Distaff/RPi_CM_Drone_Board/CM5IO_BOM.xlsx

Sheet: Bottom
Qty/ board | Ref | Value | Footprint | Desc | Part No. | MOUSER |  | Farnell |  | TME
 |  |  |  |  |  | Unit Price | Code | Unit Price | Code | Unit Price | Code | min. Il. na 10 płytek
4 | C9,C12,C13,C18 | 100n | Capacitor_SMD:C_0402_1005Metric | 0.1uF 10% 16V Ceramic Capacitor X7R 0402 (1005 Metric) | - |  |  |  |  | 0.04 zł | 04025C104KAT2A (https://www.tme.eu/pl/details/04025c104kat2a/kondensatory-mlcc-smd/kyocera-avx/) | 12 | 0.47 zł
1 | CP6 | 33pF | Capacitor_SMD:C_0805_2012Metric_Pad1.18x1.45mm_HandSolder | - | - |  |  |  |  | 0.20 zł | 08055A330KAT2A (https://www.tme.eu/pl/details/08055a330kat2a/kondensatory-mlcc-smd/kyocera-avx/) | 12 | 2.46 zł
1 | CP5 | 2.7nF | Capacitor_SMD:C_0805_2012Metric_Pad1.18x1.45mm_HandSolder | - | - |  |  |  |  | 0.18 zł | 08055C272KAT2A (https://www.tme.eu/pl/details/08055c272kat2a/kondensatory-mlcc-smd/kyocera-avx/) | 12 | 2.19 zł
1 | CP7 | 10nF | Capacitor_SMD:C_0805_2012Metric_Pad1.18x1.45mm_HandSolder | - | - |  |  |  |  | 0.14 zł | 08055C103KAT2A (https://www.tme.eu/pl/details/08055c103kat2a/kondensatory-mlcc-smd/kyocera-avx/) | 12 | 1.71 zł
1 | CP4 | 100nF | Capacitor_SMD:C_0805_2012Metric_Pad1.18x1.45mm_HandSolder | - | - |  |  |  |  | 0.04 zł | 08055C104KAT2A (https://www.tme.eu/pl/details/08055c104kat2a/kondensatory-mlcc-smd/kyocera-avx/) | 12 | 0.50 zł
4 | C2,C5,C7,C8 | 10u | Capacitor_SMD:C_0805_2012Metric | 10uF 10% 10V Ceramic Capacitor X7R 0805 (2012 Metric) | - |  |  |  |  | 0.28 zł | 08055C105KAT2A (https://www.tme.eu/pl/details/08055c105kat2a/kondensatory-mlcc-smd/kyocera-avx/) | 42 | 11.85 zł
3 | R1,R2,R10 | 1k | Resistor_SMD:R_0402_1005Metric | Resistor 1K M1005 1% 63mW | - |  |  |  |  | 0.03 zł | SMD0402-1K-1% (https://www.tme.eu/pl/details/smd0402-1k-1%25/rezystory-smd/royalohm-royal-electronic-fty-co/0402wgf1001tce/) | 100 | 3.31 zł
4 | R6,R7,R8,R9 | 2.2K 1% | Resistor_SMD:R_0402_1005Metric | Resistor 2.2K M1005 1% 63mW | - |  |  |  |  | 0.04 zł | SMD0402-2K2-1% (https://www.tme.eu/pl/details/smd0402-2k2-1%25/rezystory-smd/royalohm-royal-electronic-fty-co/0402wgf2201tce/) | 100 | 3.91 zł
2 | R11,R13 | 10K 1% | Resistor_SMD:R_0402_1005Metric | Resistor 10K M1005 1% 63mW | - |  |  |  |  | 0.02 zł | SMD0402-10K-1% (https://www.tme.eu/pl/details/smd0402-10k-1%25/rezystory-smd/royalohm-royal-electronic-fty-co/0402wgf1002tce/) | 100 | 1.76 zł
1 | R12 | 15K 1% | Resistor_SMD:R_0402_1005Metric | Resistor 15K M1005 1% 63mW | - |  |  |  |  | 0.04 zł | SMD0402-15K-1% (https://www.tme.eu/pl/details/smd0402-15k-1%25/rezystory-smd/royalohm-royal-electronic-fty-co/0402wgf1502tce/) | 100 | 3.66 zł
1 | RP1 | 115K | Resistor_SMD:R_0805_2012Metric_Pad1.20x1.40mm_HandSolder | - | - |  |  |  |  | 0.22 zł | ERA6AEB1153V (https://www.tme.eu/pl/details/era6aeb1153v/rezystory-smd/panasonic-industry-europe-gmbh/) | 12 | 2.59 zł
1 | RP2 | 22.1K | Resistor_SMD:R_0805_2012Metric_Pad1.20x1.40mm_HandSolder | - | - |  |  |  |  | 0.06 zł | SMD0805-22K1-1% (https://www.tme.eu/pl/details/smd0805-22k1-1%25/rezystory-smd/royalohm-royal-electronic-fty-co/0805s8f2212t5e/) | 100 | 5.94 zł
1 | RP3 | 15.8K | Resistor_SMD:R_0805_2012Metric_Pad1.20x1.40mm_HandSolder | - | - |  |  |  |  | 0.07 zł | SMD0805-15.8K-1% (https://www.tme.eu/pl/details/smd0805-15.8k-1%25/rezystory-smd/royalohm-royal-electronic-fty-co/0805s8f1582t5e/) | 100 | 6.71 zł
1 | J1 | POWER TERMINAL | TerminalBlock:TerminalBlock_bornier-2_P5.08mm | - | - |  |  |  |  |  | Will be unused |  | 0.00 zł
1 | J2 | Conn_02x06_Odd_Even | Connector_PinHeader_2.00mm:PinHeader_2x06_P2.00mm_Vertical | PinHeader_2x06_P2.54mm_Vertical | - |  |  |  |  | 1.09 zł | ZL303-2X40P (https://www.tme.eu/pl/details/zl303-2x40p/listwy-i-gniazda-kolkowe/connfly/ds1025-05-2x40p8bv1-b/) | 10 | 10.93 zł
2 | J2 |  |  | Zwory do J2 |  |  |  |  |  | 0.29 zł | JUMPER-2.0/B (https://www.tme.eu/pl/details/jumper-2.0_b/listwy-i-gniazda-kolkowe/ninigi/) | 12 | 3.53 zł
1 | J4 | J_PSU_EN | Connector_PinHeader_2.54mm:PinHeader_1x02_P2.54mm_Vertical | - | - |  |  |  |  |  |  |  | 0.00 zł
1 | J8 | THD-20-R | Connector_PinHeader_2.54mm:PinHeader_2x20_P2.54mm_Vertical | PinHeader_2x20_P2.54mm_Vertical | THD-20-R
 |  |  |  |  |  |  |  |  |  |  |  | SUMA | 61.50 zł
1 | CP1 | 10uF | Capacitor_Tantalum_SMD:CP_EIA-3528-21_Kemet-C_HandSolder | Tantalum, Kemet-C, 10uF@35V min. | - |  |  |  |  | 3.74 zł | TAJC106K035R (https://www.tme.eu/pl/details/tajc106k035r/kondensatory-tantalowe-smd/kyocera-avx/tajc106k035rnj/)
2 | CP2,CP3 | 22uF | Capacitor_Tantalum_SMD:CP_EIA-3528-21_Kemet-B_HandSolder | Tantalum, Kemet-B, 22uF@10V min. | - |  |  |  |  | 1.64 zł | TAJB226K016R (https://www.tme.eu/pl/details/tajb226k016r/kondensatory-tantalowe-smd/kyocera-avx/tajb226k016rnj/)
1 | C3 | 100uF | Capacitor_Tantalum_SMD:CP_EIA-7343-31_Kemet-D | Kemet-D, 10V | - |  |  |  |  | 2.28 zł | TAJD106K035R (https://www.tme.eu/pl/details/tajd106k035r/kondensatory-tantalowe-smd/kyocera-avx/tajd106k035rnj/)
2 | D1,D3 | LED Red | LED_SMD:LED_0603_1608Metric | Red 620nm LED Indication - Discrete 2.2V 2-SMD, No Lead | SML-A12U8TT86Q | 0.38 zł | 859-LTST-S270KRKT (https://www.mouser.pl/ProductDetail/LITEON/LTST-S270KRKT?qs=NUb82WqeCyrkrhATBGeB1A%3D%3D) | 1.65 zł | 3434715 (https://pl.farnell.com/rohm/sml-a12u8tt86/led-red-63mcd-620nm/dp/3434715) | 0.00 zł | -
1 | D2 | LED Green | LED_SMD:LED_0603_1608Metric | Green 572nm LED Indication - Discrete 2.2V 2-SMD, No Lead | SML-A12M8TT86N | 0.30 zł | 859-LTST-S270KGKT (https://www.mouser.pl/ProductDetail/LITEON/LTST-S270KGKT?qs=oL5uk4n%2FG821%2FMiCU6RADg%3D%3D) | 1.64 zł | 3434712 (https://pl.farnell.com/rohm/sml-a12m8tt86/led-yellow-green-25mcd-572nm/dp/3434712) | 0.00 zł | -
2 | J5,J16 | Conn_01x22_Female | CM5IO:Hirose_FH12-22S-0.5SH_1x22-1MP_P0.50mm_Horizontal | 22 Position FFC, FPC Connector Contacts, Bottom 0.020" (0.50mm) Surface Mount, Right Angle | FH12-22S-0.5SH55 | 5.68 zł | 798-FH12-22S-0.5SH55 (https://www.mouser.pl/ProductDetail/Hirose-Connector/FH12-22S-0.5SH55?qs=Ux3WWAnHpjDjN9JNAugKTA%3D%3D) | 7.17 zł | 2300373 (https://pl.farnell.com/hirose-hrs/fh12-22s-1sh-55/connector-fpc-ffc-smt-1mm-22way/dp/2300373) | 0.00 zł | -
1 | J7 | Micro_SD_Card_Det | CM5IO:SDCARD_MOLEX_503398-1892 | 9 (8 + 1) Position Card Connector microSDâ„¢ Surface Mount, Right Angle Gold | 503398-1892 |  |  |  |  | 8.41 zł | MX-503398-1892 (https://www.tme.eu/pl/details/mx-503398-1892/zlacza-do-kart/molex-interconnect-gmbh/503398-1892/) | Not necessary, if no SD card is used
1 | J11 | USB_C_Receptacle_USB2.0 | Connector_USB:USB_C_Receptacle_GCT_USB4105-xx-A_16P_TopMnt_Horizontal | USBC USB2 data and power connector | USBF31-0171 |  |  |  |  | 2.51 zł | USB4105-GF-A-060 (substitute) (https://www.tme.eu/pl/details/usb4105-gf-a-060/zlacza-usb-i-ieee1394/gct/)
1 | J12 | USB3_A | Connector_USB:USB3_A_Molex_48393-001 | USB 3.0 A connector | 48393-0003 |  |  |  |  | 9.67 zł | MX-48393-0003 (https://www.tme.eu/pl/details/mx-48393-0003/zlacza-usb-i-ieee1394/molex-interconnect-gmbh/48393-0003/)
1 | J14 | JST_SHBM04B-SRSS-TB | Connector_JST:JST_SH_BM04B-SRSS-TB_1x04-1MP_P1.00mm_Vertical | 4 pin vertical 1mm pitch connector | SHBM04B-SRSS-TB |  |  |  |  | 1.44 zł | SM04B-SRSS-TB (https://www.tme.eu/pl/details/sm04b-srss-tb/zlacza-sygnalowe-raster-1-00mm/jst-j-s-t-deutschland-gmbh/sm04b-srss-tb-lf-sn/)
1 | J22 | 46765-1301 | CM5IO:CONN_467651301_MOL | 0.40mm Pitch Micro HDMI Connector, Right-Angle Receptacle, Surface Mount, with Through Hole Shell Tabs and Pick-and-Place Polyimide Tape, 19 Circuits, Lead-Free | 46765-1301 | 7.70 zł | 538-46765-1301 (https://www.mouser.pl/ProductDetail/Molex/46765-1301?qs=73RpG39PUGhn7Y4KPCbKEQ%3D%3D) | 8.82 zł | 2614867 (https://pl.farnell.com/molex/46765-1301/hdmi-connector-rcpt-19pos-smt/dp/2614867) | 0.00 zł | -
1 | LP1 | 3.6uH | Inductor_SMD:L_Bourns-SRN8040_8x8.15mm | - | SRN8040HA-3R6M | 1.70 zł | 652-SRN8040HA-3R6M (https://www.mouser.pl/ProductDetail/Bourns/SRN8040HA-3R6M?qs=2SLPxufLcgCU8ox1jv6zYw%3D%3D) | 2.52 zł | 4216300 (https://pl.farnell.com/bourns/srn8040ha-3r6m/power-inductor-3-6uh-semishielded/dp/4216300) | 0.00 zł | -
2 | Module1 | ComputeModule5-CM5 | CM5IO:Raspberry-Pi-5-Compute-Module | 100 Position Connector Receptacle, Center Strip Contacts Surface Mount Gold | 10164227-1001A1RLF | 5.55 zł | DF40C-100DS-0.4V(51) (substitute) (https://www.mouser.pl/ProductDetail/Hirose-Connector/DF40C-100DS-0.4V51?qs=eDUdFcBPps2MEwbnuPvZzQ%3D%3D) | 7.43 zł | 4137104 (https://pl.farnell.com/amphenol-communications-solutions/10164227-1001a1rlf/mezzanine-conn-rcpt-100pos-2row/dp/4137104) | 0.00 zł | -
1 | SW1 | Right angle Tact button | Button_Switch_SMD:SW_Push_1P1T_NO_CK_KMR2 | - | KMR221G LFS |  |  |  |  | 1.05 zł | KMR221GLFS (https://www.tme.eu/pl/details/kmr221glfs/mikroprzelaczniki-tact/c-k-components-sas/kmr221g-lfs/)
1 | U6 | AP22653W6 | Package_TO_SOT_SMD:SOT-23-6 | Power Switch/Driver 1:1 P-Channel 2.1A SOT-23-6 | AP22653W6 |  |  |  |  | 1.45 zł | AP22653W6-7 (https://www.tme.eu/pl/details/ap22653w6-7/power-switches-uklady-scalone/diodes-incorporated/)
1 | U12 | RT9742SNGV | Package_TO_SOT_SMD:TSOT-23_HandSoldering | Power Switch/Driver 1:1 N-Channel 500mA SOT-23-3 | RT9742SNGV | 1.04 zł | 835-RT9742SNGV (https://www.mouser.pl/ProductDetail/Richtek/RT9742SNGV?qs=amGC7iS6iy9IuhGfX55LJA%3D%3D) | 1.50 zł | 2575555 (https://pl.farnell.com/richtek/rt9742sngv/uswi00154-rt9742sngv/dp/2575555) | 0.00 zł | -
1 | U18 | RT9742GGJ5 | Package_TO_SOT_SMD:SOT-23-5 | Power Switch/Driver 1:1 N-Channel 1A TSOT-23-5 | RT9742GGJ5 | 1.19 zł | 835-RT9742GGJ5 (https://www.mouser.pl/ProductDetail/Richtek/RT9742GGJ5?qs=amGC7iS6iy%2FZU2tAnLZxIA%3D%3D) | 0.00 zł | - | 0.00 zł | - | Not necessary, if no SD card is used
1 | UP1 | AP64501SP-13 | CM5IO:SOP_AP64501SP-13_DIO | - | AP64501SP-13 |  |  |  |  | 7.11 zł | AP64501SP-13 (https://www.tme.eu/pl/details/ap64501sp-13/regulatory-napiecia-uklady-dc-dc/diodes-incorporated/)
 |  |  |  |  |  | 35.17 zł | SUMA / płytka | 46.98 zł | SUMA / płytka | 40.94 zł | SUMA / płytka

Sheet: Top
Qty/ board | Ref | Value | Footprint | Desc | Part No. | MOUSER |  | Farnell |  | TME
 |  |  |  |  |  | Unit Price | Code | Unit Price | Code | Unit Price | Code | min. Il. na 10 płytek
1 | J8 | THD-20-R | Connector_PinHeader_2.54mm:PinHeader_2x20_P2.54mm_Vertical | TODO: to ma być gniazdo | - |  |  |  |  |  |  |  | 0.00 zł
1 | J3 | J_PSU_EN | Connector_PinHeader_2.54mm:PinHeader_1x02_P2.54mm_Vertical_SMD_Pin1Left | - | - |  |  |  |  |  |  |  | 0.00 zł
4 | C1,C2,C7,C8 | 470nF | Capacitor_SMD:C_0805_2012Metric_Pad1.18x1.45mm_HandSolder | - | - |  |  |  |  | 0.25 zł | 08055C474K4T2A (https://www.tme.eu/pl/details/08055c474k4t2a/kondensatory-mlcc-smd/kyocera-avx/) | 50 | 12.36 zł
10 | R1,R3,R4,R5,R6,R9,R10,R12,R13,R15 | 1K | Resistor_SMD:R_0805_2012Metric_Pad1.20x1.40mm_HandSolder | - | - |  |  |  |  | 0.05 zł | SMD0805-1K-1% (https://www.tme.eu/pl/details/smd0805-1k-1%25/rezystory-smd/royalohm-royal-electronic-fty-co/0805s8f1001t5e/) | 100 | 4.97 zł
1 | R2 | 2.2K 1% | Resistor_SMD:R_0805_2012Metric_Pad1.20x1.40mm_HandSolder | - | - |  |  |  |  | 0.06 zł | SMD0805-2K2-1% (https://www.tme.eu/pl/details/smd0805-2k2-1%25/rezystory-smd/royalohm-royal-electronic-fty-co/0805s8f2201t5e/) | 100 | 5.62 zł
2 | R7,R8 | 5.1K 1% | Resistor_SMD:R_0805_2012Metric_Pad1.20x1.40mm_HandSolder | - | - |  |  |  |  | 0.06 zł | SMD0805-5K1-1% (https://www.tme.eu/pl/details/smd0805-5k1-1%25/rezystory-smd/royalohm-royal-electronic-fty-co/0805s8f5101t5e/) | 100 | 5.94 zł
3 | R11,R14,R16 | 10K | Resistor_SMD:R_0805_2012Metric_Pad1.20x1.40mm_HandSolder | - | - |  |  |  |  | 0.05 zł | SMD0805-10K-1% (https://www.tme.eu/pl/details/smd0805-10k-1%25/rezystory-smd/royalohm-royal-electronic-fty-co/0805s8f1002t5e/) | 100 | 4.97 zł
 |  |  |  |  |  |  |  |  |  |  |  | SUMA/całość | 33.85 zł
2 | C3,C4 | 4.7uF 35v | Capacitor_Tantalum_SMD:CP_EIA-3528-21_Kemet-B_HandSolder | - | - |  |  |  |  | 1.68 zł | TAJB475K035R (https://www.tme.eu/pl/details/tajb475k035r/kondensatory-tantalowe-smd/kyocera-avx/tajb475k035rnj/)
2 | C5,C6 | 4.7uF 10v | Capacitor_Tantalum_SMD:CP_EIA-3216-18_Kemet-A_HandSolder | - | - |  |  |  |  | 1.48 zł | TAJA475K010R (https://www.tme.eu/pl/details/taja475k010r/kondensatory-tantalowe-smd/kyocera-avx/taja475k010rnj/)
2 | D1,D2 | MBR1020VL | Diode_SMD:D_SOD-123F | - | MBR1020VL |  |  |  |  | 0.98 zł | MBR1020VL-AU-R1 (https://www.tme.eu/pl/details/mbr1020vl-au-r1/diody-schottky-smd/panjit-semiconductor-panjit-international-inc/mbr1020vl-au-r1-000a1/)
2 | D3,D5 | LED Red | LED_SMD:LED_0603_1608Metric | Red 620nm LED Indication - Discrete 2.2V 2-SMD, No Lead | SML-A12U8TT86Q |  |  |  |  | 0.15 zł | LTST-C190KRKT (substitute) (https://www.tme.eu/pl/details/ltst-c190krkt/diody-led-smd-kolorowe/lite-on-technology/) | * - equivalent
1 | D4 | LED Green | LED_SMD:LED_0603_1608Metric | Green 572nm LED Indication - Discrete 2.2V 2-SMD, No Lead | SML-A12M8TT86N |  |  |  |  | 0.12 zł | LTST-C190KGKT (substitute) (https://www.tme.eu/pl/details/ltst-c190kgkt/diody-led-smd-kolorowe/lite-on-technology/)
1 | J1 | USB_C_Receptacle_USB2.0 | Connector_USB:USB_C_Receptacle_GCT_USB4105-xx-A_16P_TopMnt_Horizontal | - |  |  |  |  |  | 2.51 zł | USB4105-GF-A-060 (substitute) (https://www.tme.eu/pl/details/usb4105-gf-a-060/zlacza-usb-i-ieee1394/gct/)
1 | J4 | J_ESP_DBG_UART | Connector_Molex:Molex_PicoBlade_53047-0310_1x03_P1.25mm_Vertical | - | 53047-0310 |  |  |  |  | 1.05 zł | MX-53047-0310 (https://www.tme.eu/pl/details/mx-53047-0310/zlacza-sygnalowe-raster-1-25mm/molex/53047-0310/)
1 | J7 | J_FC_UART | Connector_Molex:Molex_PicoBlade_53048-0210_1x02_P1.25mm_Horizontal | - | 53048-0210 |  |  |  |  | 0.93 zł | MX-53048-0210 (https://www.tme.eu/pl/details/mx-53048-0210/zlacza-sygnalowe-raster-1-25mm/molex-interconnect-gmbh/53048-0210/)
2 | J9,J10 |  | Connector_Molex:Molex_PicoBlade_53048-0810_1x08_P1.25mm_Horizontal | - | 53048-0810 |  |  |  |  | 2.25 zł | MX-53048-0810 (https://www.tme.eu/pl/details/mx-53048-0810/zlacza-sygnalowe-raster-1-25mm/molex-interconnect-gmbh/53048-0810/)
2 | Q1,Q4 | AO3401A | Package_TO_SOT_SMD:SOT-23 | - | AO3401A |  |  |  |  | 1.24 zł | AO3401A (https://www.tme.eu/pl/details/ao3401a/tranzystory-z-kanalem-p-smd/alpha-omega-semiconductor-inc/)
2 | Q2,Q3 | Q_NPN_BEC | Package_TO_SOT_SMD:SOT-23 | -
3 | SW1,SW2,SW3 |  | Button_Switch_SMD:SW_Push_1P1T_NO_CK_KMR2 | - | KMR221G LFS |  |  |  |  | 1.05 zł | KMR221GLFS (https://www.tme.eu/pl/details/kmr221glfs/mikroprzelaczniki-tact/c-k-components-sas/kmr221g-lfs/)
1 | U1 | ESP32-S3-WROOM-1 | RF_Module:ESP32-S3-WROOM-1U | - | ESP32-S3-WROOM-1 |  |  |  |  | 23.40 zł | ESP32S3-WRM1U-16R8 (https://www.tme.eu/pl/details/esp32s3-wrm1u-16r8/moduly-iot-wifi-bluetooth/espressif-systems/esp32-s3-wroom-1u-n16r8/)
1 | U2 | Wio-SX1262 | CM5IO_top:Wio-SX1262 | - | Seed Studio 114993390 | 18.75 zł | 713-114993390 (https://www.mouser.pl/ProductDetail/Seeed-Studio/114993390) |  |  | 0.00 zł | -
2 | U3,U4 | AP7361C-33E | Package_TO_SOT_SMD:SOT-223-3_TabPin2 | - | AP7361C-33E |  |  |  |  | 1.53 zł | AP7361C-33E-13 (https://www.tme.eu/pl/details/ap7361c-33e-13/stabilizatory-napiecia-nieregulowane-ldo/diodes-incorporated/)
1 |  |  |  | LoRa - Antena | ANTX150P116B08683 | 3.41 zł | ANTX150P116B08683 (https://www.mouser.pl/ProductDetail/Pulse-Electronics/ANTX150P116B08683?qs=MLItCLRbWsxhiIxzWM7gXA%3D%3D)
 |  |  |  |  |  | 22.16 zł | SUMA / płytka |  |  | 49.77 zł | SUMA / płytka

Sheet: MOUSER ZAMÓWIENIE
Kod | Ilość
859-LTST-S270KRKT (https://www.mouser.pl/ProductDetail/LITEON/LTST-S270KRKT?qs=NUb82WqeCyrkrhATBGeB1A%3D%3D) | 30
859-LTST-S270KGKT (https://www.mouser.pl/ProductDetail/LITEON/LTST-S270KGKT?qs=oL5uk4n%2FG821%2FMiCU6RADg%3D%3D) | 30
798-FH12-22S-0.5SH55 (https://www.mouser.pl/ProductDetail/Hirose-Connector/FH12-22S-0.5SH55?qs=Ux3WWAnHpjDjN9JNAugKTA%3D%3D) | 15
538-46765-1301 (https://www.mouser.pl/ProductDetail/Molex/46765-1301?qs=73RpG39PUGhn7Y4KPCbKEQ%3D%3D) | 10
652-SRN8040HA-3R6M (https://www.mouser.pl/ProductDetail/Bourns/SRN8040HA-3R6M?qs=2SLPxufLcgCU8ox1jv6zYw%3D%3D) | 10
DF40C-100DS-0.4V(51) (substitute) (https://www.mouser.pl/ProductDetail/Hirose-Connector/DF40C-100DS-0.4V51?qs=eDUdFcBPps2MEwbnuPvZzQ%3D%3D) | 20
835-RT9742SNGV (https://www.mouser.pl/ProductDetail/Richtek/RT9742SNGV?qs=amGC7iS6iy9IuhGfX55LJA%3D%3D) | 10
835-RT9742GGJ5 (https://www.mouser.pl/ProductDetail/Richtek/RT9742GGJ5?qs=amGC7iS6iy%2FZU2tAnLZxIA%3D%3D) | 10
713-114993390 (https://www.mouser.pl/ProductDetail/Seeed-Studio/114993390) | 12 | Aternatywa (https://www.seeedstudio.com/Wio-SX1262-Wireless-Module-p-5981.html)
ANTX150P116B08683 (https://www.mouser.pl/ProductDetail/Pulse-Electronics/ANTX150P116B08683?qs=MLItCLRbWsxhiIxzWM7gXA%3D%3D) | 14
