Distaff/RPi_CM_Drone_Board/pcb_CMDB_Adv/CMDB_Adv.kicad_pcb

## KiCad design pcb_CMDB_Adv/CMDB_Adv.kicad_pcb (2026-07-15)

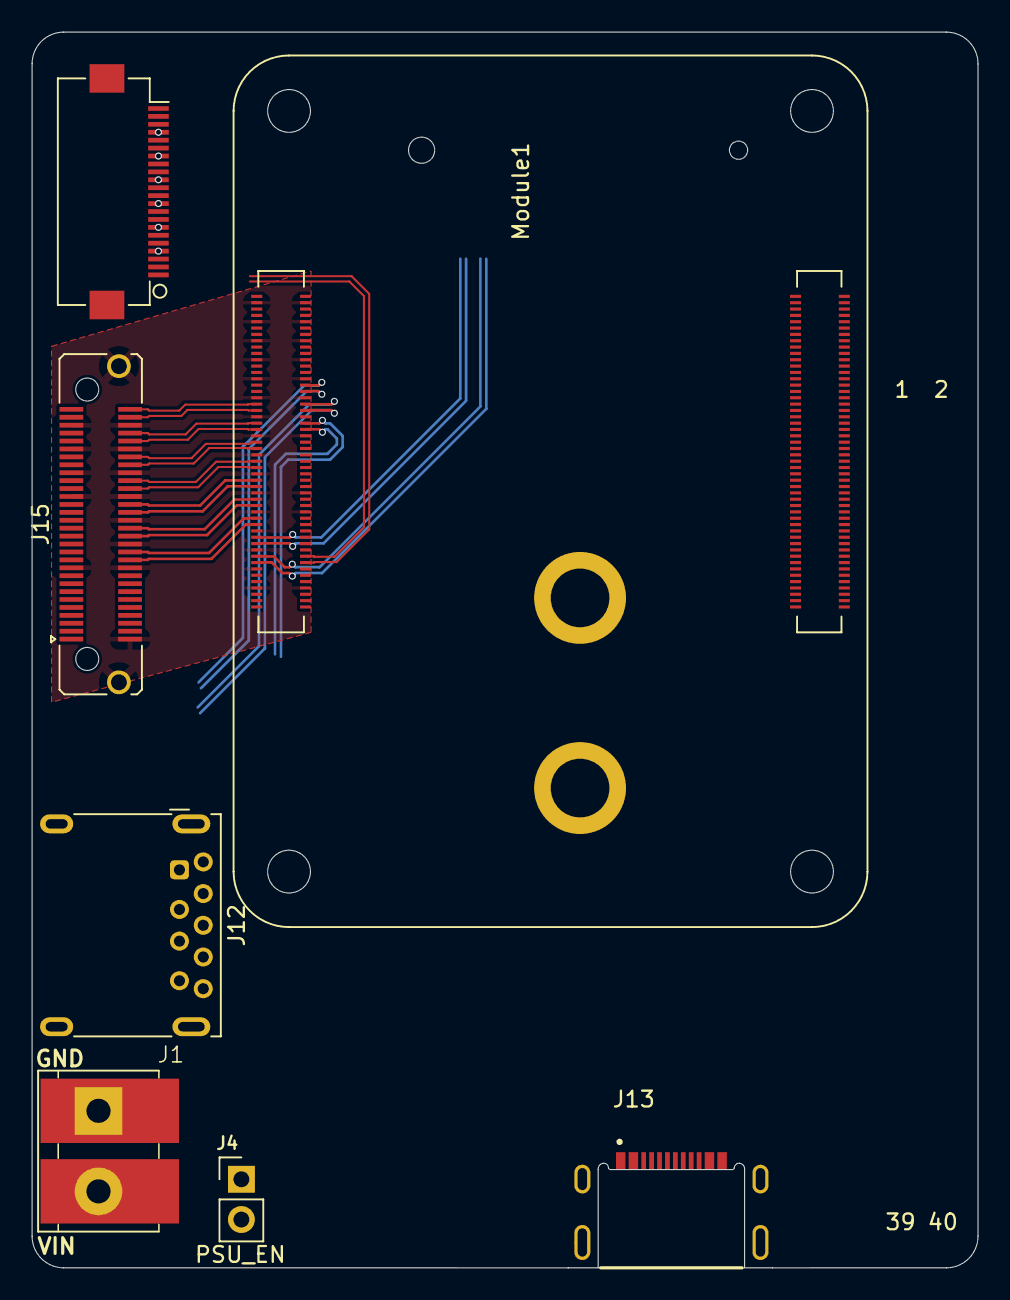
[picture p1: board CMDB_Adv.kicad_pcb from above]

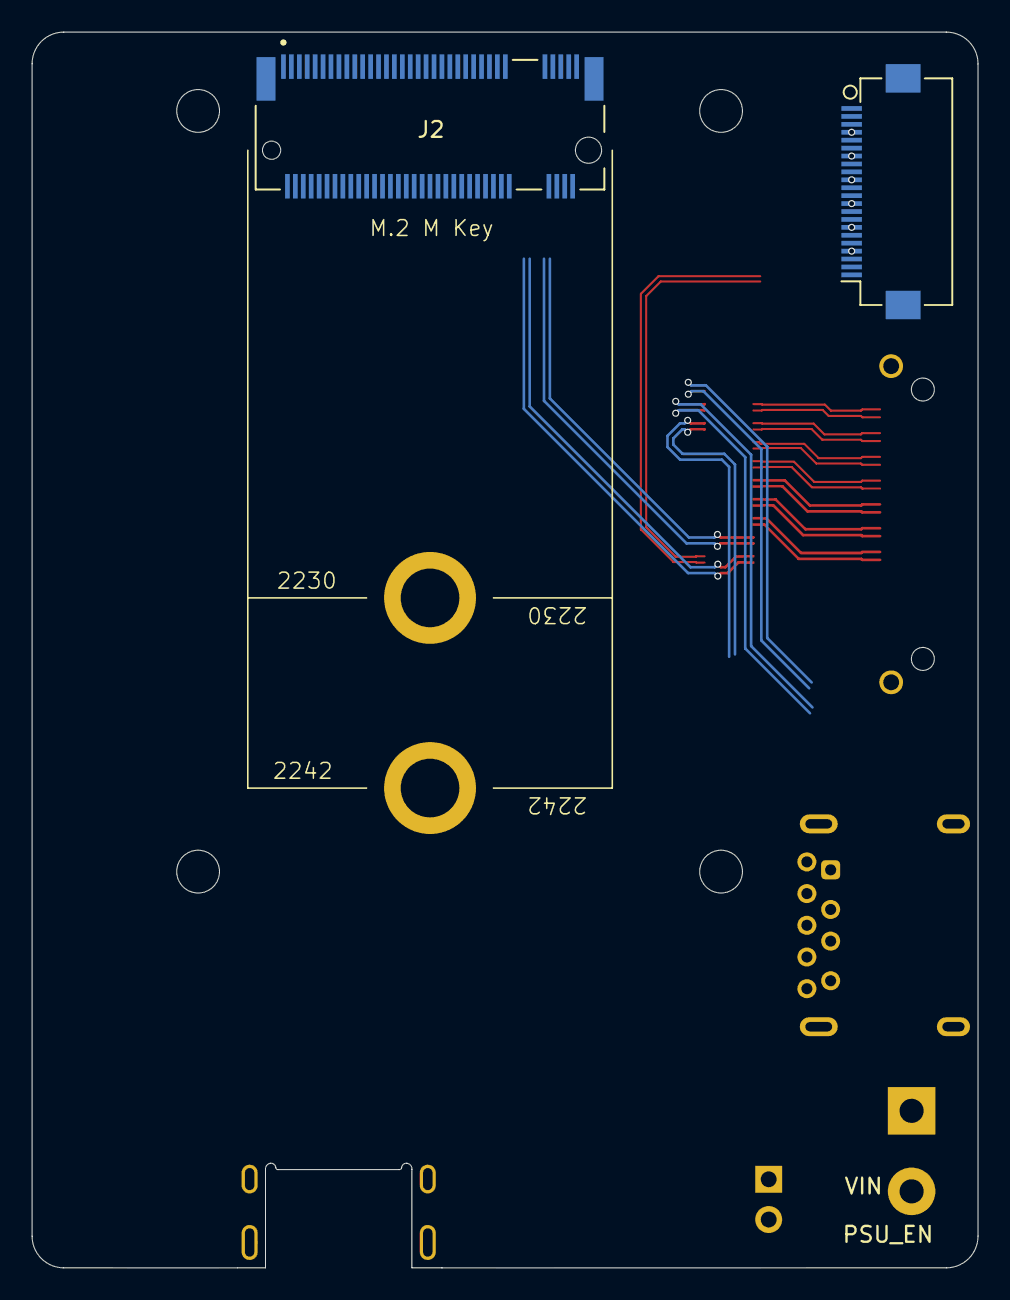
[picture p2: board CMDB_Adv.kicad_pcb from below]

Board: 6 copper layers, 59.7 x 78.0 mm, 9 parts (2 on the bottom side), 77 nets.

Parts:
J1: POWER TERMINAL; Power Terminal
J2: Bus_M.2_Socket_M; M.2 M Key socket
J4: J_PSU_EN; PinHeader_1x02_P2.54mm_Vertical
J12: CONN_USB3_A; USB3_A_Molex_48393-001
J13: CONN_USB_PWR_OTG; GCT_USB4510-03-1-A_REVA
J15: CONN_DOCK; Samtec_LSHM-130-xx.x-x-DV-S_2x30-1SH_P0.50mm_Vertical
J16: CONN_CAM1; Hirose_FH12-22S-0.5SH_1x22-1MP_P0.50mm_Horizontal
J17: CONN_CAM0; Hirose_FH12-22S-0.5SH_1x22-1MP_P0.50mm_Horizontal
Module1: ComputeModule5-CM5; Raspberry-Pi-5-Compute-Module

Connections:
/CM5/+3.3v_RPi: Module1.78 (GPIO_VREF(1.8v/3.3v_Input)), Module1.84 (+3.3v_(Output)), Module1.86 (+3.3v_(Output))
/CM5/+5v: Module1.77 (+5v_(Input)), Module1.79 (+5v_(Input)), Module1.81 (+5v_(Input)), Module1.83 (+5v_(Input)), Module1.85 (+5v_(Input)), Module1.87 (+5v_(Input))
/CM5/CAM0_GPIO0: J17.17, Module1.97 (CAM_GPIO0)
/CM5/CAM0_GPIO1: J17.18, Module1.100 (CAM_GPIO1)
/CM5/HDMI0.CEC: J15.15, Module1.151 (HDMI0_CEC)
/CM5/HDMI0.CK_N: J15.59, Module1.190 (HDMI0_CLK_N)
/CM5/HDMI0.CK_P: J15.57, Module1.188 (HDMI0_CLK_P)
/CM5/HDMI0.D0_N: J15.53, Module1.184 (HDMI0_TX0_N)
/CM5/HDMI0.D0_P: J15.51, Module1.182 (HDMI0_TX0_P)
/CM5/HDMI0.D1_N: J15.47, Module1.178 (HDMI0_TX1_N)
/CM5/HDMI0.D1_P: J15.45, Module1.176 (HDMI0_TX1_P)
/CM5/HDMI0.D2_N: J15.41, Module1.172 (HDMI0_TX2_N)
/CM5/HDMI0.D2_P: J15.39, Module1.170 (HDMI0_TX2_P)
/CM5/HDMI0.HP: J15.17, Module1.153 (HDMI0_HOTPLUG)
/CM5/HDMI0.SCL: J15.11, Module1.200 (HDMI0_SCL)
/CM5/HDMI0.SDA: J15.13, Module1.199 (HDMI0_SDA)
/CM5/HDMI1.CEC: J15.16, Module1.149 (HDMI1_CEC)
/CM5/HDMI1.CK_N: J15.60, Module1.166 (HDMI1_CLK_N)
/CM5/HDMI1.CK_P: J15.58, Module1.164 (HDMI1_CLK_P)
/CM5/HDMI1.D0_N: J15.54, Module1.160 (HDMI1_TX0_N)
/CM5/HDMI1.D0_P: J15.52, Module1.158 (HDMI1_TX0_P)
/CM5/HDMI1.D1_N: J15.48, Module1.154 (HDMI1_TX1_N)
/CM5/HDMI1.D1_P: J15.46, Module1.152 (HDMI1_TX1_P)
/CM5/HDMI1.D2_N: J15.42, Module1.148 (HDMI1_TX2_N)
/CM5/HDMI1.D2_P: J15.40, Module1.146 (HDMI1_TX2_P)
/CM5/HDMI1.HP: J15.18, Module1.143 (HDMI1_HOTPLUG)
/CM5/HDMI1.SCL: J15.12, Module1.147 (HDMI1_SCL)
/CM5/HDMI1.SDA: J15.14, Module1.145 (HDMI1_SDA)
/CM5/MIPI0.CK_N: J17.8, Module1.127 (MIPI0_C_N)
/CM5/MIPI0.CK_P: J17.9, Module1.129 (MIPI0_C_P)
/CM5/MIPI0.D0_N: J17.2, Module1.115 (MIPI0_D0_N)
/CM5/MIPI0.D0_P: J17.3, Module1.117 (MIPI0_D0_P)
/CM5/MIPI0.D1_N: J17.5, Module1.121 (MIPI0_D1_N)
/CM5/MIPI0.D1_P: J17.6, Module1.123 (MIPI0_D1_P)
/CM5/MIPI0.D2_N: J17.11, Module1.133 (MIPI0_D2_N)
/CM5/MIPI0.D2_P: J17.12, Module1.135 (MIPI0_D2_P)
/CM5/MIPI0.D3_N: J17.14, Module1.139 (MIPI0_D3_N)
/CM5/MIPI0.D3_P: J17.15, Module1.141 (MIPI0_D3_P)
/CM5/MIPI0_ID_SCL: J17.20, Module1.80 (SCL0)
/CM5/MIPI0_ID_SDA: J17.21, Module1.82 (SDA0)
/CM5/MIPI1.CK_N: J16.8, Module1.187 (MIPI1_C_N)
/CM5/MIPI1.CK_P: J16.9, Module1.189 (MIPI1_C_P)
/CM5/MIPI1.D0_N: J16.2, Module1.175 (MIPI1_D0_N)
/CM5/MIPI1.D0_P: J16.3, Module1.177 (MIPI1_D0_P)
/CM5/MIPI1.D1_N: J16.5, Module1.181 (MIPI1_D1_N)
/CM5/MIPI1.D1_P: J16.6, Module1.183 (MIPI1_D1_P)
/CM5/MIPI1.D2_N: J16.11, Module1.193 (MIPI1_D2_N)
/CM5/MIPI1.D2_P: J16.12, Module1.195 (MIPI1_D2_P)
/CM5/MIPI1.D3_N: J16.14, Module1.194 (MIPI1_D3_N)
/CM5/MIPI1.D3_P: J16.15, Module1.196 (MIPI1_D3_P)
/CM5/PCIe.CLK_N: J2.53 (REFCLKn), Module1.112 (PCIe_CLK_N)
/CM5/PCIe.CLK_P: J2.55 (REFCLKp), Module1.110 (PCIe_CLK_P)
/CM5/PCIe.RX_N: J2.41 (PETn0), Module1.118 (PCIe_RX_N)
/CM5/PCIe.RX_P: J2.43 (PETp0), Module1.116 (PCIe_RX_P)
/CM5/PCIe.TX_N: J2.47 (PERn0), Module1.124 (PCIe_TX_N)
/CM5/PCIe.TX_P: J2.49 (PERp0), Module1.122 (PCIe_TX_P)
/CM5/PCIe.nCLKREQ: J2.52 (~CLKREQ), Module1.102 (PCIe_nCLKREQ)
/CM5/PCIe.nRST: J2.50 (~PERST), Module1.109 (PCIe_nRST)
/CM5/PCIe.nWAKE: J2.54 (~PEWAKE), Module1.104 (PCIE_nWAKE)
/CM5/USB0.D_N: J15.30, Module1.136 (USB3-0-D_N)
/CM5/USB0.D_P: J15.28, Module1.134 (USB3-0-D_P)
/CM5/USB0.RX_N: J15.22, Module1.128 (USB3-0-RX_N)
/CM5/USB0.RX_P: J15.24, Module1.130 (USB3-0-RX_P)
/CM5/USB0.TX_N: J15.34, Module1.140 (USB3-0-TX_N)
/CM5/USB0.TX_P: J15.36, Module1.142 (USB3-0-TX_P)
/CM5/USB1.D_N: J12.6 (SSRX+), Module1.165 (USB3-1-D_N)
/CM5/USB1.D_P: J12.5 (SSRX-), Module1.163 (USB3-1-D_P)
/CM5/USB1.RX_N: J12.2 (D-), Module1.157 (USB3-1-RX_N)
/CM5/USB1.RX_P: J12.3 (D+), Module1.159 (USB3-1-RX_P)
/CM5/USB1.TX_N: J12.8 (SSTX-), Module1.169 (USB3-1-TX_N)
/CM5/USB1.TX_P: J12.9 (SSTX+), Module1.171 (USB3-1-TX_P)
/Connectors/+3.3v: J15.1, J16.22, J17.22
/Connectors/USBC.D_N: J13.A7 (D-), J13.B7 (D-)
/Connectors/USBC.D_P: J13.A6 (D+), J13.B6 (D+)
/M2_3V3: J2.2 (3.3V), J2.4 (3.3V), J2.12 (3.3V), J2.14 (3.3V), J2.16 (3.3V), J2.18 (3.3V), J2.70 (3.3V), J2.72 (3.3V), J2.74 (3.3V)
/PSU/VIN: J1.2 (VIN), J4.1
GND: J1.1 (GND), J2.1 (GND), J2.3 (GND), J2.9 (GND), J2.15 (GND), J2.21 (GND), J2.27 (GND), J2.33 (GND), J2.39 (GND), J2.45 (GND), J2.51 (GND), J2.57 (GND), J2.71 (GND), J2.73 (GND), J2.75 (GND), J2.M1 (GND2230), J2.M2 (GND2242), J2.S1, J2.S2, J12.4 (GND), J12.7 (DRAIN), J12.10 (SHIELD), J13.S1 (SHIELD), J15.2, J15.19, J15.20, J15.26, J15.32, J15.37, J15.38, J15.43, J15.44, J15.49, J15.50, J15.55, J15.56, J15.SH (Shield), J16.1, J16.4, J16.7, J16.10, J16.13, J16.16, J16.19, J17.1, J17.4, J17.7, J17.10, J17.13, J17.16, J17.19, Module1.1 (GND), Module1.2 (GND), Module1.4 (Ethernet_Pair1_P), Module1.6 (Ethernet_Pair1_N), Module1.7 (GND), Module1.8 (GND), Module1.11 (Ethernet_Pair2_P), Module1.13 (GND), Module1.14 (GND), Module1.22 (GND), Module1.23 (GND), Module1.32 (GND), Module1.33 (GND), Module1.35 (ID_SC), Module1.36 (ID_SD), Module1.41 (GPIO25), Module1.42 (GND), Module1.43 (GND), Module1.52 (GND), Module1.53 (GND), Module1.59 (GND), Module1.60 (GND), Module1.62 (SD_CMD), Module1.65 (GND), Module1.66 (GND), Module1.71 (GND), Module1.74 (GND), Module1.98 (GND), Module1.107 (GND), Module1.108 (GND), Module1.113 (GND), Module1.114 (GND), Module1.119 (GND), Module1.120 (GND), Module1.125 (GND), Module1.126 (GND), Module1.131 (GND), Module1.132 (GND), Module1.137 (GND), Module1.138 (GND), Module1.144 (GND), Module1.150 (GND), Module1.155 (GND), Module1.156 (GND), Module1.161 (GND), Module1.162 (GND), Module1.167 (GND), Module1.168 (GND), Module1.173 (GND), Module1.174 (GND), Module1.179 (GND), Module1.180 (GND), Module1.185 (GND), Module1.186 (GND), Module1.191 (GND), Module1.192 (GND), Module1.197 (GND), Module1.198 (GND)
