Distaff/RPi_CM_Drone_Board/CM5IO_top/CM5IO_top.kicad_pcb

## KiCad design CM5IO_top/CM5IO_top.kicad_pcb (2026-02-01)

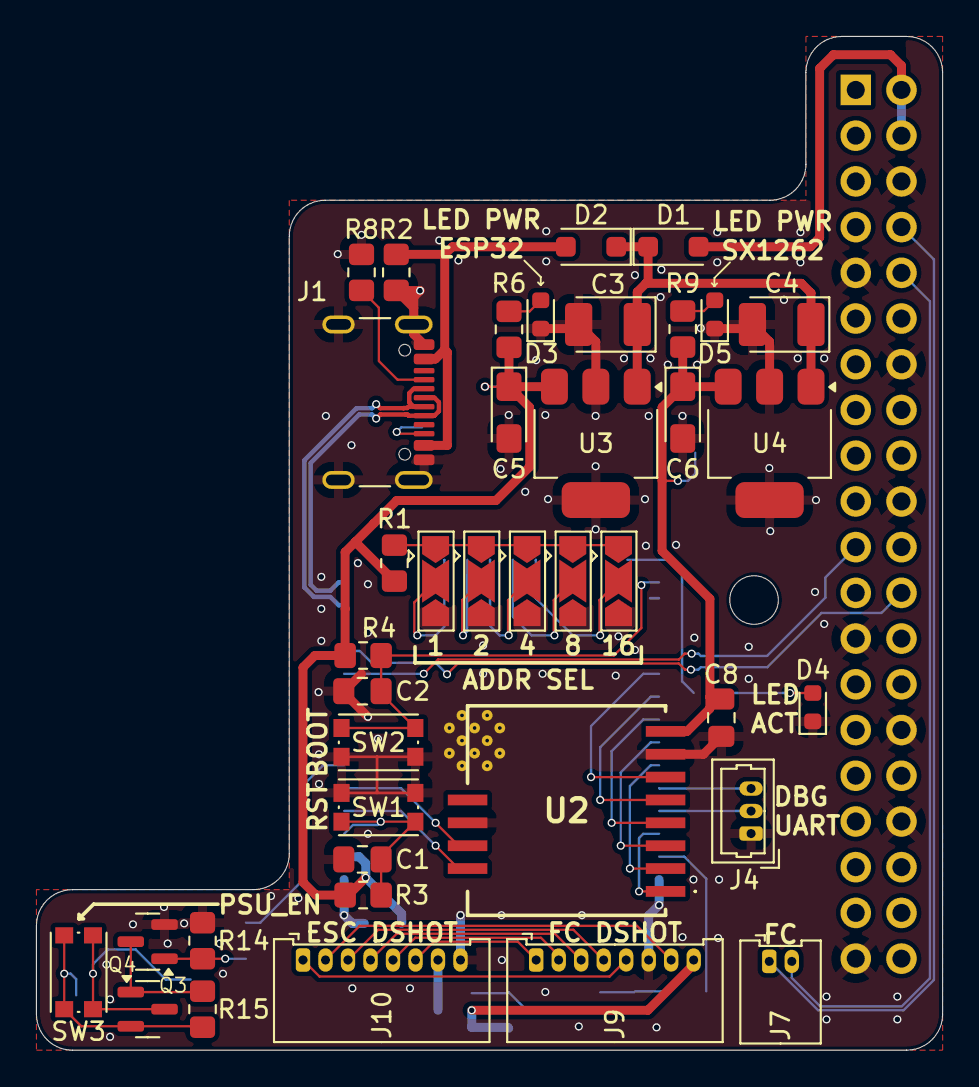
[picture p3: board CM5IO_top.kicad_pcb from above]

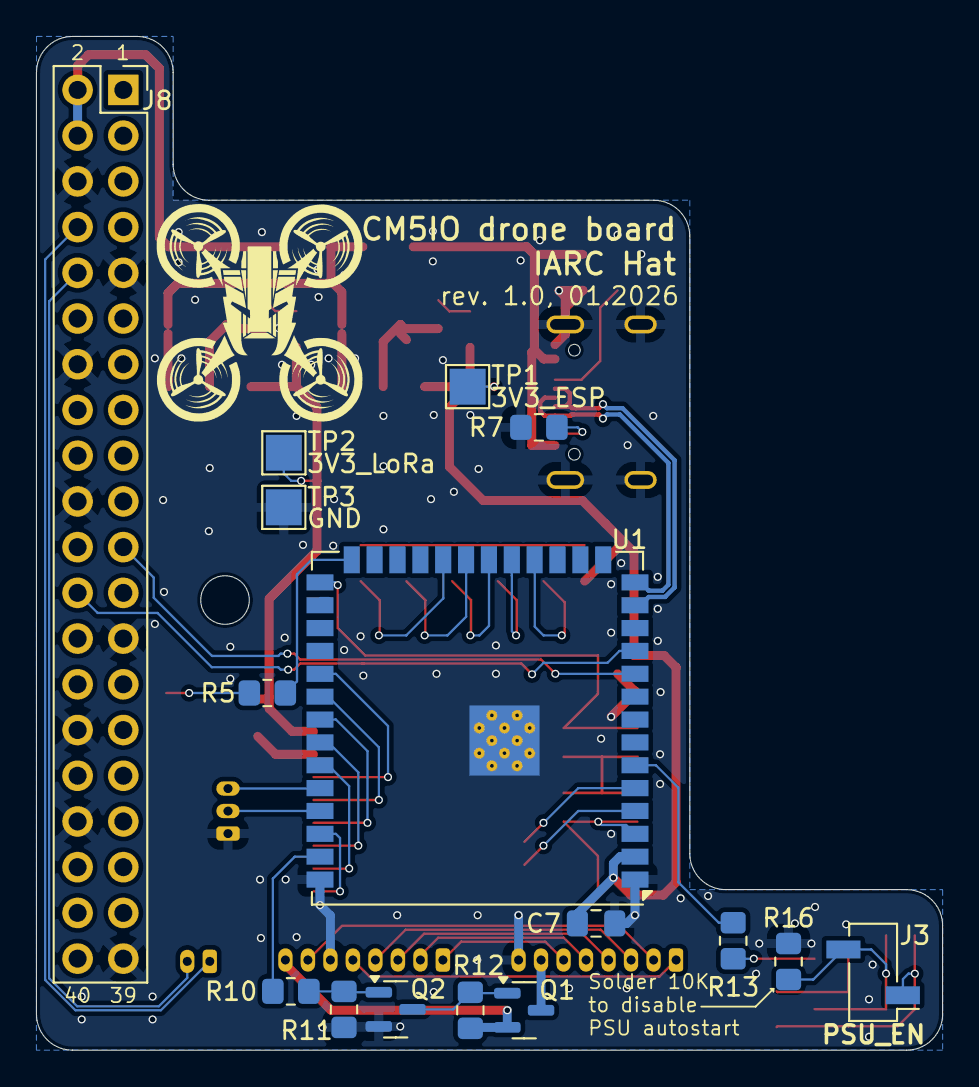
[picture p4: board CM5IO_top.kicad_pcb from below]

Board: 2 copper layers, 50.3 x 56.3 mm, 57 parts (16 on the bottom side), 52 nets.

Parts:
C1, C2, C7, C8: 470nF; C_0805_2012Metric_Pad1.18x1.45mm_HandSolder
C3, C4: 4.7uF 35v; CP_EIA-3528-21_Kemet-B_HandSolder
C5, C6: 4.7uF 10v; CP_EIA-3216-18_Kemet-A_HandSolder
D1, D2: MBR1020VL; D_SOD-123F
D3, D5: LED Red; LED_0603_1608Metric
D4: LED Green; LED_0603_1608Metric
H1: MountingHole; MountingHole_2.7mm_M2.5_DIN965
J1: USB_C_Receptacle_USB2.0; USB_C_Receptacle_GCT_USB4105-xx-A_16P_TopMnt_Horizontal
J3: J_PSU_EN; PinSocket_1x02_P2.54mm_Vertical_SMD_Pin1Left
J4: J_ESP_DBG_UART; Molex_PicoBlade_53047-0310_1x03_P1.25mm_Vertical
J7: J_FC_UART; Molex_PicoBlade_53048-0210_1x02_P1.25mm_Horizontal
J8: THD-20-R; PinSocket_2x20_P2.54mm_Vertical
J9: J_DShot600_ESC; Molex_PicoBlade_53048-0810_1x08_P1.25mm_Horizontal
J10: J_DShot600_FC; Molex_PicoBlade_53048-0810_1x08_P1.25mm_Horizontal
JP1: ADDR1; SolderJumper-3_P2.0mm_Open_TrianglePad1.0x1.5mm
JP2: ADDR2; SolderJumper-3_P2.0mm_Open_TrianglePad1.0x1.5mm
JP3: ADDR4; SolderJumper-3_P2.0mm_Open_TrianglePad1.0x1.5mm
JP4: ADDR8; SolderJumper-3_P2.0mm_Open_TrianglePad1.0x1.5mm
JP5: ADDR16; SolderJumper-3_P2.0mm_Open_TrianglePad1.0x1.5mm
Module1: ComputeModule5-CM5; Raspberry-Pi-5-Compute-Module
Q1, Q4: AO3401A; SOT-23
Q2, Q3: Q_NPN_BEC; SOT-23
R1, R3, R4, R5, R6, R9, R10, R12, R13, R15: 1K; R_0805_2012Metric_Pad1.20x1.40mm_HandSolder
R2: 2.2K 1%; R_0805_2012Metric_Pad1.20x1.40mm_HandSolder
R7, R8: 5.1K 1%; R_0805_2012Metric_Pad1.20x1.40mm_HandSolder
R11, R14, R16: 10K; R_0805_2012Metric_Pad1.20x1.40mm_HandSolder
SW1: SW_RESET; SW_Push_1P1T_NO_CK_KMR2
SW2: SW_BOOT; SW_Push_1P1T_NO_CK_KMR2
SW3: FORCE_PWR; SW_Push_1P1T_NO_CK_KMR2
TP1: 3V3_ESP; TestPoint_Pad_2.0x2.0mm
TP2: 3V3_LORA; TestPoint_Pad_2.0x2.0mm
TP3: GND; TestPoint_Pad_2.0x2.0mm
U1: ESP32-S3-WROOM-1; ESP32-S3-WROOM-1U
U2: Wio-SX1262
U3, U4: AP7361C-33E; SOT-223-3_TabPin2

Connections:
/+3.3v_ESP: C5.1, C7.2, R1.1, R3.1, R4.1, R6.1, TP1.1, U1.2 (3V3), U3.3 (VO)
/+3.3v_LoRa: C6.1, C8.2, R9.1, TP2.1, U2.8 (VCC), U4.3 (VO)
/+5v_RPi: D1.2 (A), J8.2, J8.4
/+5v_USB: D2.2 (A), J1.A4 (VBUS), J1.A9 (VBUS), J1.B4 (VBUS), J1.B9 (VBUS), R2.1
/Comm/ADDR1: JP1.2 (C), U1.18 (IO10)
/Comm/ADDR2: JP2.2 (C), U1.19 (IO11)
/Comm/ADDR4: JP3.2 (C), U1.20 (IO12)
/Comm/ADDR8: JP4.2 (C), U1.21 (IO13)
/Comm/ADDR16: JP5.2 (C), U1.22 (IO14)
/Comm/ADDR_HIGH: JP1.1 (A), JP2.1 (A), JP3.1 (A), JP4.1 (A), JP5.1 (A), R1.2
/Comm/BOOT_MODE: C2.2, R4.2, SW2.2, U1.27 (IO0)
/Comm/ENABLE: C1.2, R3.2, SW1.2, U1.3 (EN)
/Comm/KILLSWITCH_FC_CTL: R10.1, U1.39 (IO1)
/Comm/KILLSWITCH_PSU_CTL: R13.1, U1.6 (IO6)
/Comm/LED_ACT: R5.1, U1.26 (IO45)
/Comm/LORA_BUSY: U1.5 (IO5), U2.11 (BUSY)
/Comm/LORA_DIO1: U1.4 (IO4), U2.12 (DIO1)
/Comm/LORA_RESET: U1.32 (IO39), U2.5 (NRST)
/Comm/LORA_RF_SW: U1.38 (IO2), U2.1 (RF_SW_)
/Comm/LORA_SPI_CLK: U1.33 (IO40), U2.4 (SCK)
/Comm/LORA_SPI_CS: U1.31 (IO38), U2.6 (NSS)
/Comm/LORA_SPI_MISO: U1.35 (IO42), U2.2 (MISO)
/Comm/LORA_SPI_MOSI: U1.34 (IO41), U2.3 (MOSI)
/Dshot600_CURR: J9.5, J10.1
/Dshot600_M1: J9.4, J10.3
/Dshot600_M2: J9.3, J10.4
/Dshot600_M3: J9.2, J10.5
/Dshot600_M4: J9.1, J10.6
/Dshot600_R7: J9.7, J10.2
/ESP_USB2_N: J1.A7 (D-), J1.B7 (D-), U1.13 (USB_D-)
/ESP_USB2_P: J1.A6 (D+), J1.B6 (D+), U1.14 (USB_D+)
/GPIO8: J8.24, U1.11 (IO18)
/GPIO9: J8.21, U1.10 (IO17)
/GPIO14_UART_TX: J7.1, J8.8
/GPIO15_UART_RX: J7.2, J8.10
/PSU_CTL_EN: J3.2, Q4.3 (D), R16.1, SW3.1
/PSU_VIN: J3.1, Q4.2 (S), R15.1, SW3.2
/VBUS_ESC: J9.8, Q1.2 (S), R12.1
/VBUS_FC: J10.7, Q1.3 (D)
/VIN: C3.1, C4.1, D1.1 (K), D2.1 (K), U3.1 (VI), U4.1 (VI)
GND: C1.1, C2.1, C3.2, C4.2, C5.2, C6.2, C7.1, C8.1, D3.1 (K), D4.1 (K), D5.1 (K), J1.A1 (GND), J1.A12 (GND), J1.B1 (GND), J1.B12 (GND), J1.S1 (SHIELD), J4.1, J8.6, J8.9, J8.14, J8.20, J8.25, J8.30, J8.34, J8.39, J9.6, J10.8, JP1.3 (B), JP2.3 (B), JP3.3 (B), JP4.3 (B), JP5.3 (B), Q2.2 (E), Q3.2 (E), R2.2, R7.1, R8.1, R11.2, R14.2, R16.2, SW1.1, SW2.1, TP3.1, U1.1 (GND), U1.40 (GND), U1.41 (GND), U2.7 (GND_1), U2.10 (GND_2), U3.2 (GND), U4.2 (GND)
unnamed: D3.2 (A), R6.2
unnamed: D4.2 (A), R5.2
unnamed: D5.2 (A), R9.2
unnamed: J1.A5 (CC1), R8.2
unnamed: J1.B5 (CC2), R7.2
unnamed: J4.2, U1.37 (TXD0)
unnamed: J4.3, U1.36 (RXD0)
unnamed: Q1.1 (G), Q2.3 (C), R12.2
unnamed: Q2.1 (B), R10.2, R11.1
unnamed: Q3.1 (B), R13.2, R14.1
unnamed: Q3.3 (C), Q4.1 (G), R15.2
