Distaff/RPi_CM_Drone_Board/CM5IO/CM5IO.kicad_pcb

## KiCad design CM5IO/CM5IO.kicad_pcb (2026-01-29)

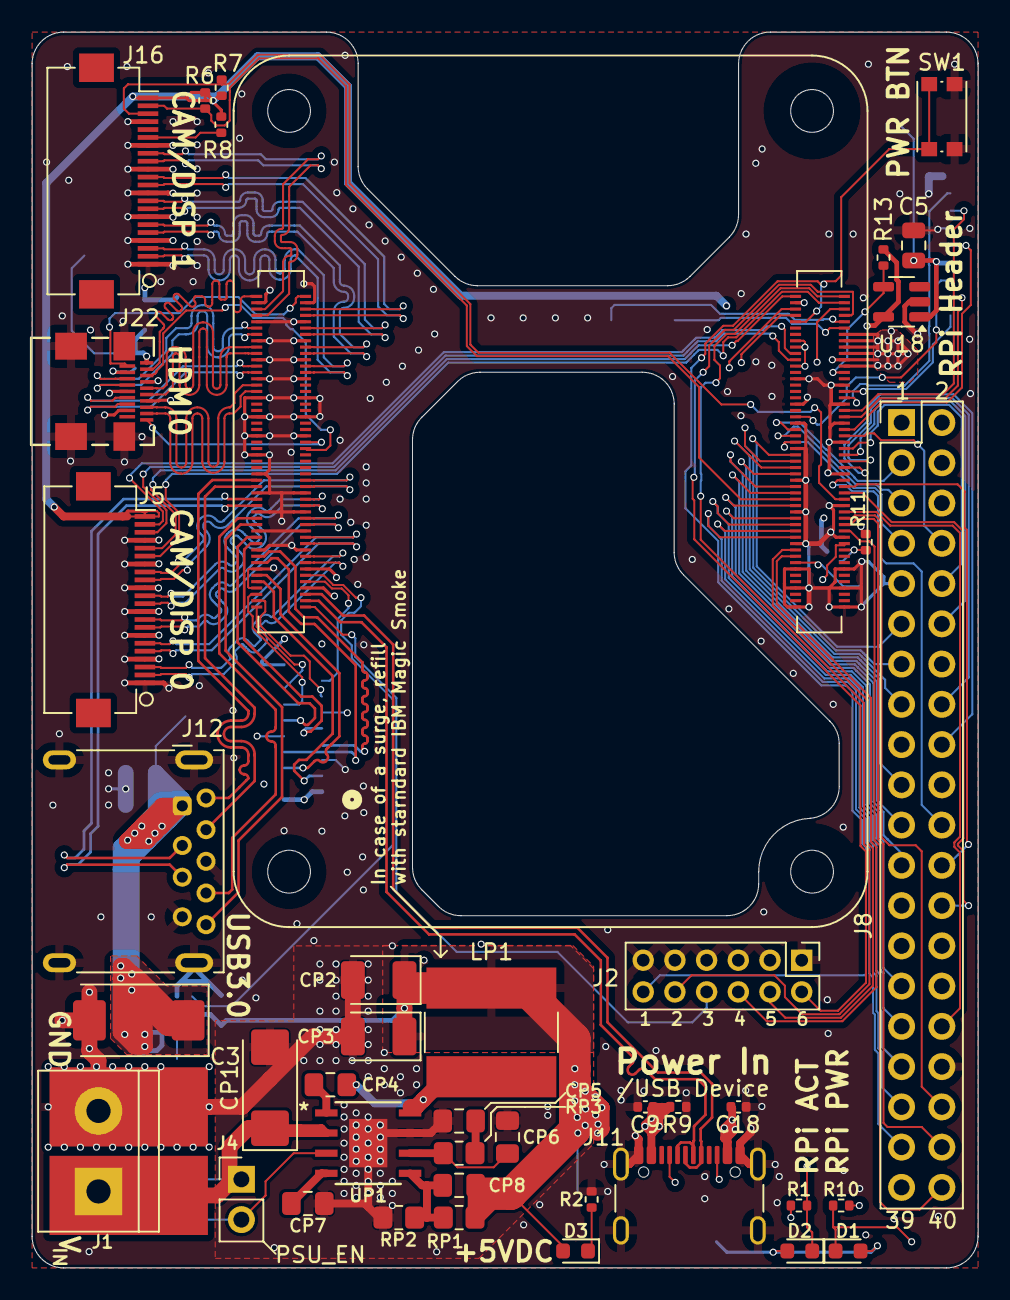
[picture p5: board CM5IO.kicad_pcb from above]

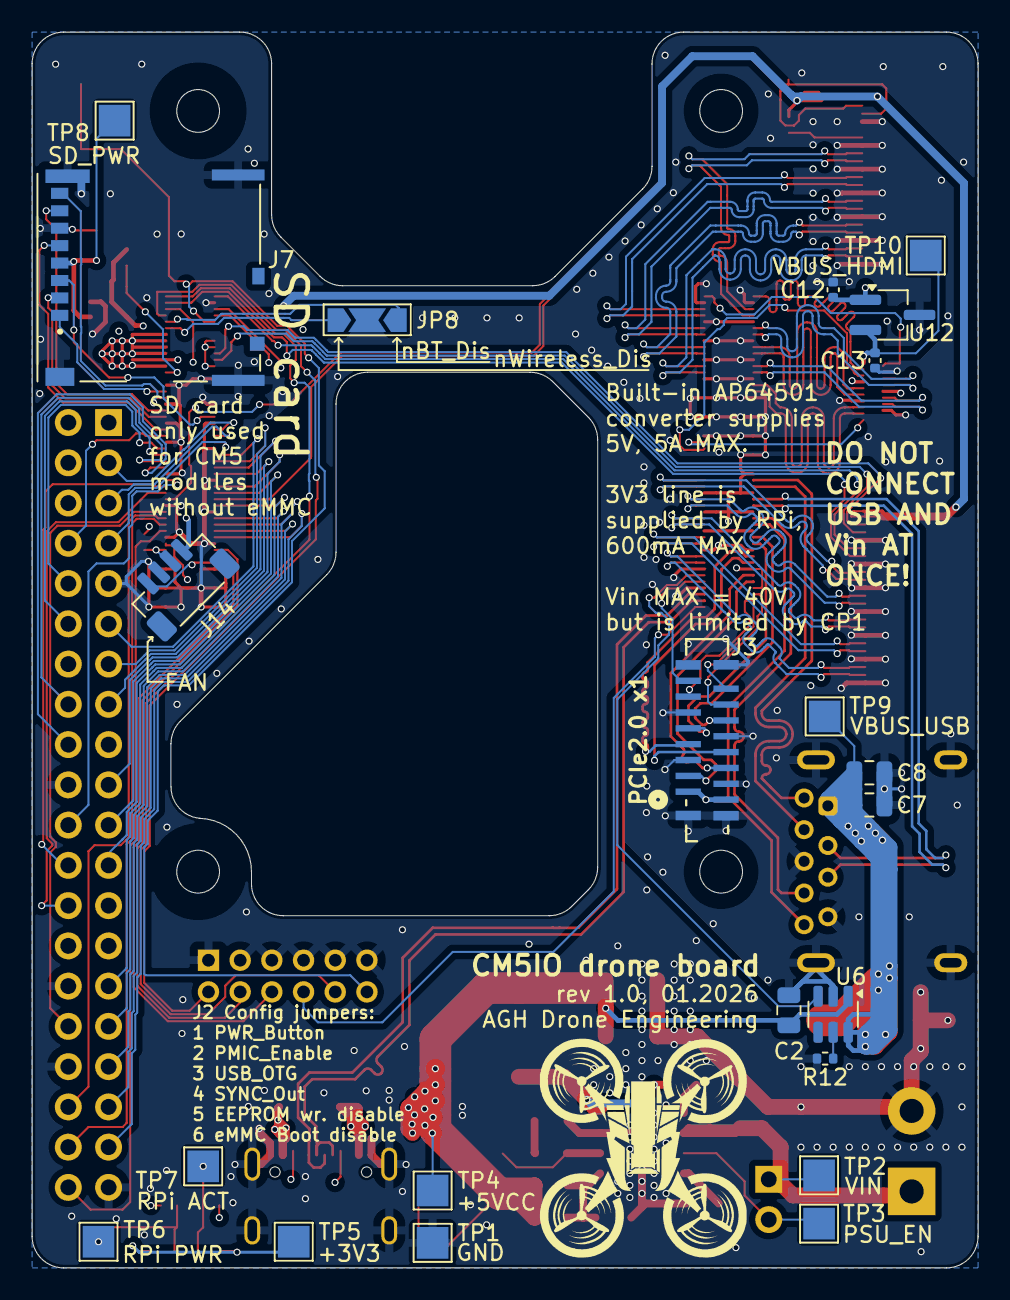
[picture p6: board CM5IO.kicad_pcb from below]

Board: 4 copper layers, 59.7 x 78.0 mm, 65 parts (22 on the bottom side), 123 nets.

Parts:
C2, C5, C7, C8: 10u; C_0805_2012Metric
C3: 100uF; CP_EIA-7343-31_Kemet-D
C9, C12, C13, C18: 100n; C_0402_1005Metric
CP1: 10uF; CP_EIA-6032-28_Kemet-C_HandSolder
CP2, CP3: 22uF; CP_EIA-3528-21_Kemet-B_HandSolder
CP4: 100nF; C_0805_2012Metric_Pad1.18x1.45mm_HandSolder
CP5: 2.7nF; C_0805_2012Metric_Pad1.18x1.45mm_HandSolder
CP6: 33pF; C_0805_2012Metric_Pad1.18x1.45mm_HandSolder
CP7: 10nF; C_0805_2012Metric_Pad1.18x1.45mm_HandSolder
CP8: OPEN; C_0805_2012Metric_Pad1.18x1.45mm_HandSolder
D1, D3: LED Red; LED_0603_1608Metric
D2: LED Green; LED_0603_1608Metric
H9: VIN_SOLDERPOINT; SolderWirePad_1x01_SMD_5x10mm
H10: GND_SOLDERPOINT; SolderWirePad_1x01_SMD_5x10mm
J1: POWER TERMINAL; TerminalBlock_bornier-2_P5.08mm
J2: Conn_02x06_Odd_Even; PinHeader_2x06_P2.00mm_Vertical
J3: 62674-161121ALF; CON16_1X16_DUT_58XF_GLE
J4: J_PSU_EN; PinHeader_1x02_P2.54mm_Vertical
J5, J16: Conn_01x22_Female; Hirose_FH12-22S-0.5SH_1x22-1MP_P0.50mm_Horizontal
J7: Micro_SD_Card_Det; SDCARD_MOLEX_503398-1892
J8: THD-20-R; PinHeader_2x20_P2.54mm_Vertical
J11: USB_C_Receptacle_USB2.0; USB_C_Receptacle_GCT_USB4105-xx-A_16P_TopMnt_Horizontal
J12: USB3_A; USB3_A_Molex_48393-001
J14: JST_SHBM04B-SRSS-TB; JST_SH_BM04B-SRSS-TB_1x04-1MP_P1.00mm_Vertical
J22: 46765-1301; CONN_467651301_MOL
JP8: BT_WIFI_DISABLE; SolderJumper-3_P2.0mm_Open_TrianglePad1.0x1.5mm
LP1: 3.6uH; L_Bourns-SRN8040_8x8.15mm
Module1: ComputeModule5-CM5; Raspberry-Pi-5-Compute-Module
R1, R2, R10: 1k; R_0402_1005Metric
R6, R7, R8, R9: 2.2K 1%; R_0402_1005Metric
R11, R13: 10K 1%; R_0402_1005Metric
R12: 15K 1%; R_0402_1005Metric
RP1: 115K; R_0805_2012Metric_Pad1.20x1.40mm_HandSolder
RP2: 22.1K; R_0805_2012Metric_Pad1.20x1.40mm_HandSolder
RP3: 15.8K; R_0805_2012Metric_Pad1.20x1.40mm_HandSolder
SW1: Right angle Tact button; SW_Push_1P1T_NO_CK_KMR2
TP1: TP GND; TestPoint_Pad_2.0x2.0mm
TP2: TP VIN; TestPoint_Pad_2.0x2.0mm
TP3: TP PSU_EN; TestPoint_Pad_2.0x2.0mm
TP4: TP +5VCC; TestPoint_Pad_2.0x2.0mm
TP5: TP +3V3; TestPoint_Pad_2.0x2.0mm
TP6: TP nPWR; TestPoint_Pad_2.0x2.0mm
TP7: TP nACT; TestPoint_Pad_2.0x2.0mm
TP8: TP SD_PWR; TestPoint_Pad_2.0x2.0mm
TP9: TP VBUS_USB; TestPoint_Pad_2.0x2.0mm
TP10: TP VBUS_HDMI; TestPoint_Pad_2.0x2.0mm
U6: AP22653W6; SOT-23-6
U12: RT9742SNGV; TSOT-23_HandSoldering
U18: RT9742GGJ5; SOT-23-5
UP1: AP64501SP-13; SOP_AP64501SP-13_DIO

Connections:
/+3.3v: D1.2 (A), D2.2 (A), J5.22, J8.1, J8.17, J16.22, Module1.78 (GPIO_VREF(1.8v/3.3v_Input)), Module1.84 (+3.3v_(Output)), Module1.86 (+3.3v_(Output)), R6.1, R7.1, R8.1, R11.1, R13.1, TP5.1, U18.5 (IN)
/+5v: C2.1, C9.1, C12.1, C18.1, CP2.1, CP3.1, CP8.1, D3.2 (A), J3.1, J3.2, J8.2, J8.4, J11.A4 (VBUS), J11.A9 (VBUS), J11.B4 (VBUS), J11.B9 (VBUS), J14.1, LP1.2, Module1.77 (+5v_(Input)), Module1.79 (+5v_(Input)), Module1.81 (+5v_(Input)), Module1.83 (+5v_(Input)), Module1.85 (+5v_(Input)), Module1.87 (+5v_(Input)), R9.1, RP1.1, TP4.1, U6.1 (IN), U12.1 (IN)
/CC1: J11.A5 (CC1), Module1.94 (CC1)
/CC2: J11.B5 (CC2), Module1.96 (CC2)
/CM5_GPIO ( Ethernet, GPIO, SDCARD)/BT_nDis: JP8.3 (B), Module1.91 (BT_nDisable)
/CM5_GPIO ( Ethernet, GPIO, SDCARD)/CAM_GPIO0: J5.17, Module1.97 (CAM_GPIO0)
/CM5_GPIO ( Ethernet, GPIO, SDCARD)/CAM_GPIO1: J5.18, Module1.100 (CAM_GPIO1)
/CM5_GPIO ( Ethernet, GPIO, SDCARD)/EEPROM_nWP: J2.4, Module1.20 (EEPROM_nWP)
/CM5_GPIO ( Ethernet, GPIO, SDCARD)/GPIO2: J8.3, Module1.58 (GPIO2)
/CM5_GPIO ( Ethernet, GPIO, SDCARD)/GPIO3: J8.5, Module1.56 (GPIO3)
/CM5_GPIO ( Ethernet, GPIO, SDCARD)/GPIO4: J8.7, Module1.54 (GPIO4)
/CM5_GPIO ( Ethernet, GPIO, SDCARD)/GPIO5: J8.29, Module1.34 (GPIO5)
/CM5_GPIO ( Ethernet, GPIO, SDCARD)/GPIO6: J8.31, Module1.30 (GPIO6)
/CM5_GPIO ( Ethernet, GPIO, SDCARD)/GPIO7: J8.26, Module1.37 (GPIO7)
/CM5_GPIO ( Ethernet, GPIO, SDCARD)/GPIO8: J8.24, Module1.39 (GPIO8)
/CM5_GPIO ( Ethernet, GPIO, SDCARD)/GPIO9: J8.21, Module1.40 (GPIO9)
/CM5_GPIO ( Ethernet, GPIO, SDCARD)/GPIO10: J8.19, Module1.44 (GPIO10)
/CM5_GPIO ( Ethernet, GPIO, SDCARD)/GPIO11: J8.23, Module1.38 (GPIO11)
/CM5_GPIO ( Ethernet, GPIO, SDCARD)/GPIO12: J8.32, Module1.31 (GPIO12)
/CM5_GPIO ( Ethernet, GPIO, SDCARD)/GPIO13: J8.33, Module1.28 (GPIO13)
/CM5_GPIO ( Ethernet, GPIO, SDCARD)/GPIO14: J8.8, Module1.55 (GPIO14)
/CM5_GPIO ( Ethernet, GPIO, SDCARD)/GPIO15: J8.10, Module1.51 (GPIO15)
/CM5_GPIO ( Ethernet, GPIO, SDCARD)/GPIO16: J8.36, Module1.29 (GPIO16)
/CM5_GPIO ( Ethernet, GPIO, SDCARD)/GPIO17: J8.11, Module1.50 (GPIO17)
/CM5_GPIO ( Ethernet, GPIO, SDCARD)/GPIO18: J8.12, Module1.49 (GPIO18)
/CM5_GPIO ( Ethernet, GPIO, SDCARD)/GPIO19: J8.35, Module1.26 (GPIO19)
/CM5_GPIO ( Ethernet, GPIO, SDCARD)/GPIO20: J8.38, Module1.27 (GPIO20)
/CM5_GPIO ( Ethernet, GPIO, SDCARD)/GPIO21: J8.40, Module1.25 (GPIO21)
/CM5_GPIO ( Ethernet, GPIO, SDCARD)/GPIO22: J8.15, Module1.46 (GPIO22)
/CM5_GPIO ( Ethernet, GPIO, SDCARD)/GPIO23: J8.16, Module1.47 (GPIO23)
/CM5_GPIO ( Ethernet, GPIO, SDCARD)/GPIO24: J8.18, Module1.45 (GPIO24)
/CM5_GPIO ( Ethernet, GPIO, SDCARD)/GPIO25: J8.22, Module1.41 (GPIO25)
/CM5_GPIO ( Ethernet, GPIO, SDCARD)/GPIO26: J8.37, Module1.24 (GPIO26)
/CM5_GPIO ( Ethernet, GPIO, SDCARD)/GPIO27: J8.13, Module1.48 (GPIO27)
/CM5_GPIO ( Ethernet, GPIO, SDCARD)/PMIC_ENABLE: J2.10, Module1.99 (PMIC_ENABLE)
/CM5_GPIO ( Ethernet, GPIO, SDCARD)/PWM: J14.2, Module1.19 (FAN_PWM), R11.2
/CM5_GPIO ( Ethernet, GPIO, SDCARD)/PWR_BUT: J2.12, Module1.92 (PWR_BUT), SW1.1
/CM5_GPIO ( Ethernet, GPIO, SDCARD)/SD_CLK: J7.5 (CLK), Module1.57 (SD_CLK)
/CM5_GPIO ( Ethernet, GPIO, SDCARD)/SD_CMD: J7.3 (CMD), Module1.62 (SD_CMD)
/CM5_GPIO ( Ethernet, GPIO, SDCARD)/SD_DAT0: J7.7 (DAT0), Module1.63 (SD_DAT0)
/CM5_GPIO ( Ethernet, GPIO, SDCARD)/SD_DAT1: J7.8 (DAT1), Module1.67 (SD_DAT1)
/CM5_GPIO ( Ethernet, GPIO, SDCARD)/SD_DAT2: J7.1 (DAT2), Module1.69 (SD_DAT2)
/CM5_GPIO ( Ethernet, GPIO, SDCARD)/SD_DAT3: J7.2 (DAT3/CD), Module1.61 (SD_DAT3)
/CM5_GPIO ( Ethernet, GPIO, SDCARD)/SD_PWR: C5.1, J7.4 (VDD), TP8.1, U18.1 (OUT)
/CM5_GPIO ( Ethernet, GPIO, SDCARD)/SD_PWR_ON: Module1.75 (SD_PWR_ON), R13.2, U18.4 (EN)
/CM5_GPIO ( Ethernet, GPIO, SDCARD)/SYNC_OUT: J2.6, Module1.18 (Ethernet_SYNC_OUT(3.3v))
/CM5_GPIO ( Ethernet, GPIO, SDCARD)/TACHO: J14.4, Module1.16 (FAN_TACHO)
/CM5_GPIO ( Ethernet, GPIO, SDCARD)/USBOTG: J2.8, Module1.101 (USB_OTG_ID)
/CM5_GPIO ( Ethernet, GPIO, SDCARD)/WL_nDis: JP8.1 (A), Module1.89 (WiFi_nDisable)
/CM5_GPIO ( Ethernet, GPIO, SDCARD)/nPWR_LED: Module1.95 (LED_nPWR), R10.2
/CM5_GPIO ( Ethernet, GPIO, SDCARD)/nRPIBOOT: J2.2, Module1.93 (nRPIBOOT)
/CM5_HighSpeed/DPHY0_C_N: J5.8, Module1.127 (MIPI0_C_N)
/CM5_HighSpeed/DPHY0_C_P: J5.9, Module1.129 (MIPI0_C_P)
/CM5_HighSpeed/DPHY0_D0_N: J5.2, Module1.115 (MIPI0_D0_N)
/CM5_HighSpeed/DPHY0_D0_P: J5.3, Module1.117 (MIPI0_D0_P)
/CM5_HighSpeed/DPHY0_D1_N: J5.5, Module1.121 (MIPI0_D1_N)
/CM5_HighSpeed/DPHY0_D1_P: J5.6, Module1.123 (MIPI0_D1_P)
/CM5_HighSpeed/DPHY0_D2_N: J5.11, Module1.133 (MIPI0_D2_N)
/CM5_HighSpeed/DPHY0_D2_P: J5.12, Module1.135 (MIPI0_D2_P)
/CM5_HighSpeed/DPHY0_D3_N: J5.14, Module1.139 (MIPI0_D3_N)
/CM5_HighSpeed/DPHY0_D3_P: J5.15, Module1.141 (MIPI0_D3_P)
/CM5_HighSpeed/DPHY1_C_N: J16.8, Module1.187 (MIPI1_C_N)
/CM5_HighSpeed/DPHY1_C_P: J16.9, Module1.189 (MIPI1_C_P)
/CM5_HighSpeed/DPHY1_D0_N: J16.2, Module1.175 (MIPI1_D0_N)
/CM5_HighSpeed/DPHY1_D0_P: J16.3, Module1.177 (MIPI1_D0_P)
/CM5_HighSpeed/DPHY1_D1_N: J16.5, Module1.181 (MIPI1_D1_N)
/CM5_HighSpeed/DPHY1_D1_P: J16.6, Module1.183 (MIPI1_D1_P)
/CM5_HighSpeed/DPHY1_D2_N: J16.11, Module1.193 (MIPI1_D2_N)
/CM5_HighSpeed/DPHY1_D2_P: J16.12, Module1.195 (MIPI1_D2_P)
/CM5_HighSpeed/DPHY1_D3_N: J16.14, Module1.194 (MIPI1_D3_N)
/CM5_HighSpeed/DPHY1_D3_P: J16.15, Module1.196 (MIPI1_D3_P)
/CM5_HighSpeed/HDMI0_CEC: J22.15 (CEC), Module1.151 (HDMI0_CEC)
/CM5_HighSpeed/HDMI0_CK_N: J22.14 (CK-), Module1.190 (HDMI0_CLK_N)
/CM5_HighSpeed/HDMI0_CK_P: J22.12 (CK+), Module1.188 (HDMI0_CLK_P)
/CM5_HighSpeed/HDMI0_D0_N: J22.11 (D0-), Module1.184 (HDMI0_TX0_N)
/CM5_HighSpeed/HDMI0_D0_P: J22.9 (D0+), Module1.182 (HDMI0_TX0_P)
/CM5_HighSpeed/HDMI0_D1_N: J22.8 (D1-), Module1.178 (HDMI0_TX1_N)
/CM5_HighSpeed/HDMI0_D1_P: J22.6 (D1+), Module1.176 (HDMI0_TX1_P)
/CM5_HighSpeed/HDMI0_D2_N: J22.5 (D2-), Module1.172 (HDMI0_TX2_N)
/CM5_HighSpeed/HDMI0_D2_P: J22.3 (D2+), Module1.170 (HDMI0_TX2_P)
/CM5_HighSpeed/HDMI0_HOTPLUG: J22.1 (HPD/HEAC-), Module1.153 (HDMI0_HOTPLUG)
/CM5_HighSpeed/HDMI0_SCL: J22.17 (SCL), Module1.200 (HDMI0_SCL)
/CM5_HighSpeed/HDMI0_SDA: J22.18 (SDA), Module1.199 (HDMI0_SDA)
/CM5_HighSpeed/HDMI_5v: C13.1, J22.19 (+5V), TP10.1, U12.2 (OUT)
/CM5_HighSpeed/PCIE_CLKREQ_N: J3.15, Module1.102 (PCIe_nCLKREQ)
/CM5_HighSpeed/PCIE_CLK_N: J3.5, Module1.112 (PCIe_CLK_N)
/CM5_HighSpeed/PCIE_CLK_P: J3.4, Module1.110 (PCIe_CLK_P)
/CM5_HighSpeed/PCIE_DET_WAKE: J3.14, Module1.104 (PCIE_nWAKE)
/CM5_HighSpeed/PCIE_PWR_EN: J3.13, Module1.106 (PCIE_PWR_EN)
/CM5_HighSpeed/PCIE_RST_B: J3.16, Module1.109 (PCIe_nRST)
/CM5_HighSpeed/PCIE_RX_N: J3.8, Module1.118 (PCIe_RX_N)
/CM5_HighSpeed/PCIE_RX_P: J3.7, Module1.116 (PCIe_RX_P)
/CM5_HighSpeed/PCIE_TX_N: J3.11, Module1.124 (PCIe_TX_N)
/CM5_HighSpeed/PCIE_TX_P: J3.10, Module1.122 (PCIe_TX_P)
/CM5_HighSpeed/SCL0: J5.20, Module1.80 (SCL0)
/CM5_HighSpeed/SCL1: J16.20, Module1.35 (ID_SC), R7.2
/CM5_HighSpeed/SDA0: J5.21, Module1.82 (SDA0)
/CM5_HighSpeed/SDA1: J16.21, Module1.36 (ID_SD), R6.2
/CM5_HighSpeed/USB3-0-D_N: J12.2 (D-), Module1.136 (USB3-0-D_N)
/CM5_HighSpeed/USB3-0-D_P: J12.3 (D+), Module1.134 (USB3-0-D_P)
/CM5_HighSpeed/USB3-0-RX_N: J12.5 (SSRX-), Module1.128 (USB3-0-RX_N)
/CM5_HighSpeed/USB3-0-RX_P: J12.6 (SSRX+), Module1.130 (USB3-0-RX_P)
/CM5_HighSpeed/USB3-0-TX_N: J12.8 (SSTX-), Module1.140 (USB3-0-TX_N)
/CM5_HighSpeed/USB3-0-TX_P: J12.9 (SSTX+), Module1.142 (USB3-0-TX_P)
/CM5_HighSpeed/VBUS: C3.1, C7.1, C8.1, J12.1 (VBUS), TP9.1, U6.6 (OUT)
/CM5_HighSpeed/VBUS_EN: Module1.111 (VBUS_EN), U6.3 (EN)
/PSU/PSU_EN: J4.2, TP3.1, UP1.3 (EN)
/PSU/SW: CP4.2, LP1.1, UP1.8 (SW)
/USB2_N: J11.A7 (D-), J11.B7 (D-), Module1.103 (USB2_N)
/USB2_P: J11.A6 (D+), J11.B6 (D+), Module1.105 (USB2_P)
/VIN: CP1.1, H9.1 (MP), J1.1, J4.1, TP2.1, UP1.2 (VIN)
GND: C2.2, C3.2, C5.2, C7.2, C8.2, C9.2, C12.2, C13.2, C18.2, CP1.2, CP2.2, CP3.2, CP5.2, CP6.2, CP7.1, H10.1 (MP), J1.2, J2.1, J2.3, J2.5, J2.7, J2.9, J2.11, J3.3, J3.6, J3.9, J3.12, J3.SH1, J3.SH2, J3.SH3, J3.SH4, J5.1, J5.4, J5.7, J5.10, J5.13, J5.16, J5.19, J7.6 (VSS), J7.11 (SHIELD), J8.6, J8.9, J8.14, J8.20, J8.25, J8.30, J8.34, J8.39, J11.A1 (GND), J11.A12 (GND), J11.B1 (GND), J11.B12 (GND), J11.S1 (SHIELD), J12.4 (GND), J12.7 (DRAIN), J12.10 (SHIELD), J14.3, J16.1, J16.4, J16.7, J16.10, J16.13, J16.16, J16.19, J22.4 (D2S), J22.7 (D1S), J22.10 (D0S), J22.13 (CKS), J22.16 (GND), J22.SH, JP8.2 (C), Module1.1 (GND), Module1.2 (GND), Module1.7 (GND), Module1.8 (GND), Module1.13 (GND), Module1.14 (GND), Module1.22 (GND), Module1.23 (GND), Module1.32 (GND), Module1.33 (GND), Module1.42 (GND), Module1.43 (GND), Module1.52 (GND), Module1.53 (GND), Module1.59 (GND), Module1.60 (GND), Module1.65 (GND), Module1.66 (GND), Module1.71 (GND), Module1.74 (GND), Module1.98 (GND), Module1.107 (GND), Module1.108 (GND), Module1.113 (GND), Module1.114 (GND), Module1.119 (GND), Module1.120 (GND), Module1.125 (GND), Module1.126 (GND), Module1.131 (GND), Module1.132 (GND), Module1.137 (GND), Module1.138 (GND), Module1.144 (GND), Module1.150 (GND), Module1.155 (GND), Module1.156 (GND), Module1.161 (GND), Module1.162 (GND), Module1.167 (GND), Module1.168 (GND), Module1.173 (GND), Module1.174 (GND), Module1.179 (GND), Module1.180 (GND), Module1.185 (GND), Module1.186 (GND), Module1.191 (GND), Module1.192 (GND), Module1.197 (GND), Module1.198 (GND), R2.2, R9.2, R12.2, RP2.2, SW1.2, TP1.1, U6.2 (GND), U12.3 (GND), U18.2 (GND), UP1.7 (GND), UP1.9 (EP)
unnamed: CP5.1, RP3.2
unnamed: D1.1 (K), R10.1, TP6.1
unnamed: D2.1 (K), R1.1, TP7.1
unnamed: D3.1 (K), R2.1
unnamed: J16.17, R8.2
unnamed: Module1.21 (LED_nACT), R1.2
unnamed: R12.1, U6.5 (ILIM)
unnamed: CP4.1, UP1.1 (BST)
unnamed: CP6.1, RP3.1, UP1.6 (COMP)
unnamed: CP8.2, RP1.2, RP2.1, UP1.5 (FB)
unnamed: CP7.2, UP1.4 (SS)
