Distaff/RPi_CM_Drone_Board/(commit log)

2026-01-29 change LEDs orientation
    [CM5IO-B_Adhesive.gbr, CM5IO-B_Courtyard.gbr, CM5IO-B_Cu.gbr, CM5IO-B_Fab.gbr, CM5IO-B_Mask.gbr, CM5IO-B_Paste.gbr, CM5IO-B_Silkscreen.gbr, CM5IO-Edge_Cuts.gbr]
2026-02-01 Upload final gerbers with personal touch TM
    [CM5IO_top-B_Adhesive.gbr, CM5IO_top-B_Courtyard.gbr, CM5IO_top-B_Cu.gbr, CM5IO_top-B_Fab.gbr, CM5IO_top-B_Mask.gbr, CM5IO_top-B_Paste.gbr, CM5IO_top-B_Silkscreen.gbr, CM5IO_top-Edge_Cuts.gbr]
2026-02-11 update BOM
    [CM5IO_BOM.xlsx]
2026-04-29 Add README for Raspberry Pi Compute Module Drone Board
    Added detailed description and images for the Raspberry Pi Compute Module Drone Board.
2026-07-15 CMDB_Adv WIP
    [CM5.kicad_sch, CM5_GPIO.kicad_sch, CM5_HighSpeed.kicad_sch, CMDB_Adv.kicad_pcb, CMDB_Adv.kicad_sch, Connectors.kicad_sch, PCIe-M2.kicad_sch, PinSel.kicad_sch]
