Distaff/RPi_CM_Drone_Board/(notices)

Notices in the files:
pcb_CMDB_Adv/CM5_HighSpeed.kicad_sch:
Copyright © 2024 Raspberry Pi Ltd.
